osuna11/edin_codigo_usher/Guantes finales render/Nuevos archivos/files para proto/Tapacompleta.stl

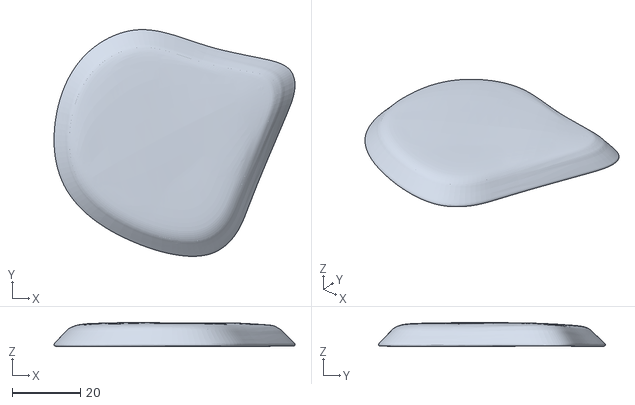
[picture p1: CAD file, 2021-05-18]
Guantes finales render/Nuevos archivos/files para proto/Tapacompleta.stl
70.7 x 66.5 x 7.12
