osuna11/edin_codigo_usher/Guantes finales render/Nuevos archivos/Solido4.STL

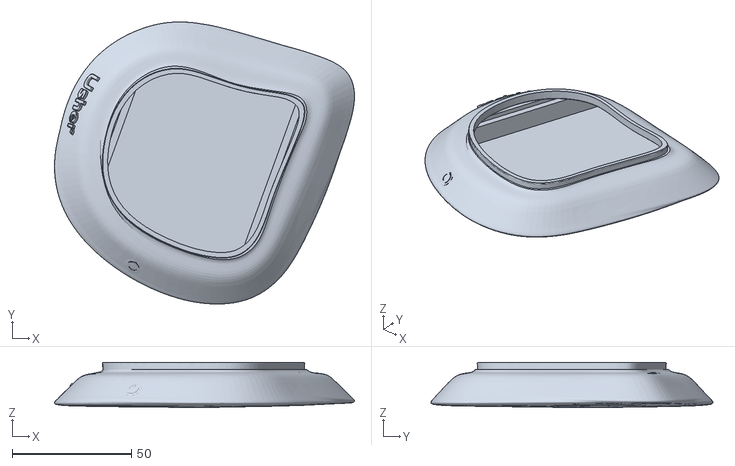
[picture p2: CAD file, 2021-05-18]
Guantes finales render/Nuevos archivos/Solido4.STL
125.7 x 118.2 x 18.9
