osuna11/edin_codigo_usher/Guantes finales render/Nuevos archivos/files para proto/BASE1-CASE.stl

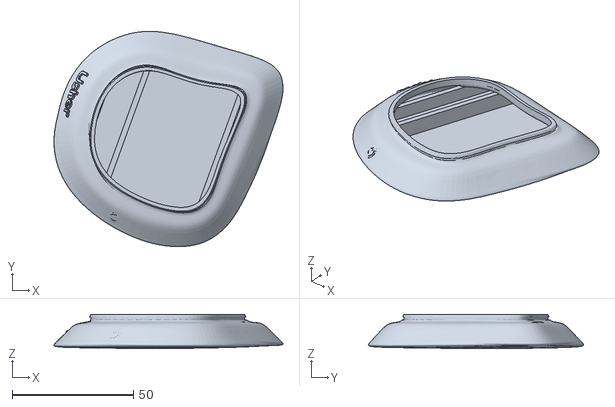
[picture p3: CAD file, 2021-05-18]
Guantes finales render/Nuevos archivos/files para proto/BASE1-CASE.stl
94.3 x 88.7 x 14.1
