osuna11/edin_codigo_usher/Guantes finales render/Nuevos archivos/Solido3.STL

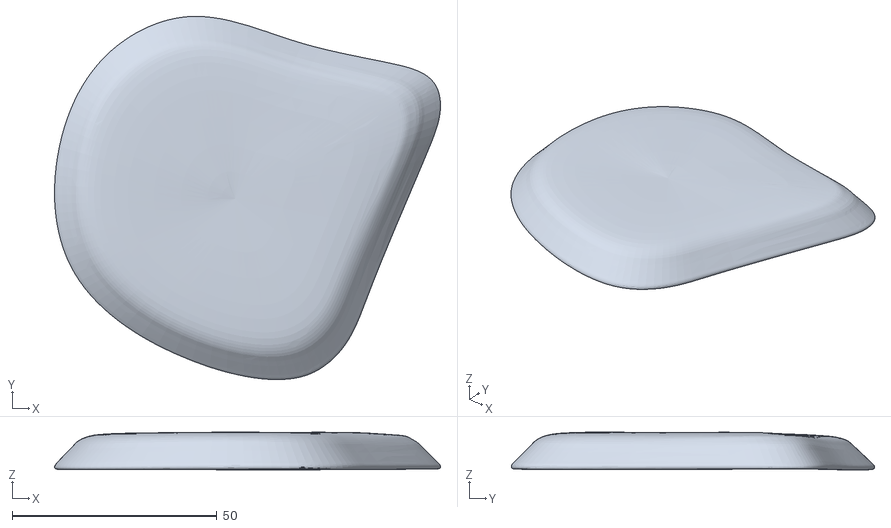
[picture p4: CAD file, 2021-05-18]
Guantes finales render/Nuevos archivos/Solido3.STL
94.3 x 88.7 x 9.22
