osuna11/edin_codigo_usher/Guantes finales render/Nuevos archivos/Solido3 (1).DXF

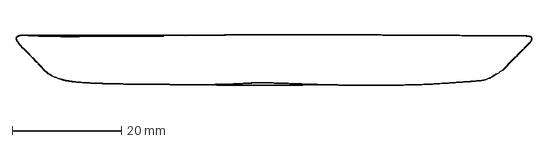
[picture p6: CAD file, 2021-05-18, an earlier design]
Guantes finales render/Nuevos archivos/Solido3 (1).DXF
94.3 x 9.23 mm
