osuna11/edin_codigo_usher/(list of files, cad)

Other CAD files:
Guantes finales render/Nuevos archivos/Solido3.DWG
Guantes finales render/Nuevos archivos/Solido4.DXF
