osuna11/edin_codigo_usher/Placa final/placa_final.brd

## EAGLE design Placa final/placa_final.brd (2021-05-18)

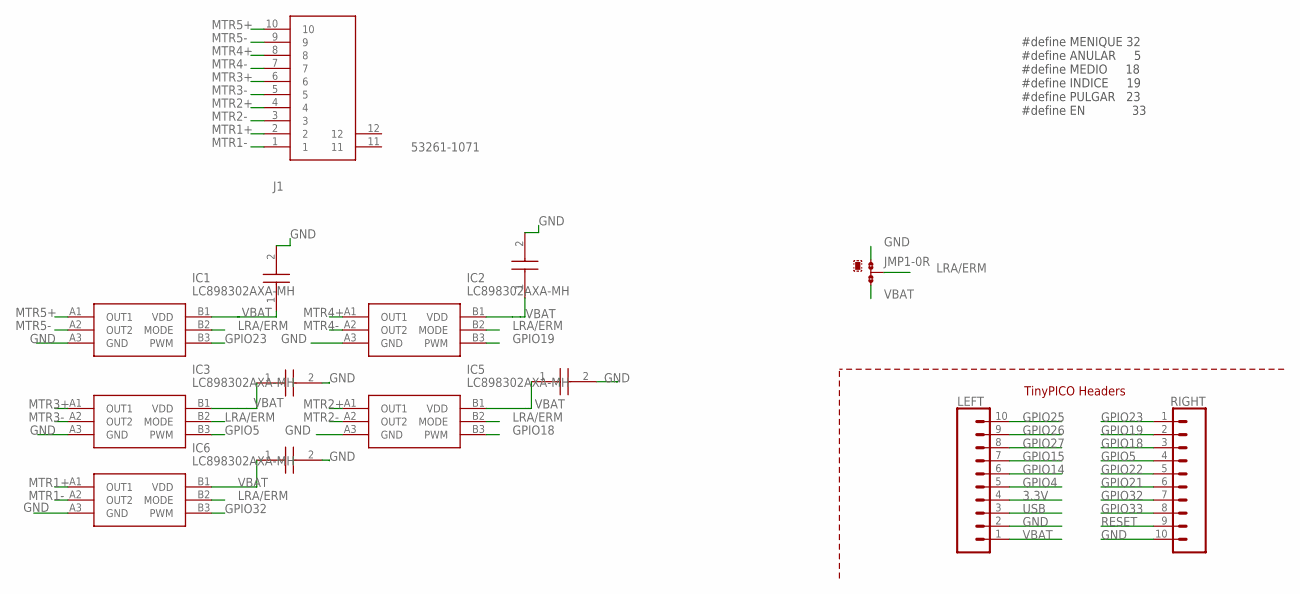
[picture p7: schematic placa_final.sch, sheet 1]

Parts:
C1, C2, C3, C4, C5: 0603B104K160CT; CAPC1608X87N
IC1, IC2, IC3, IC5, IC6: LC898302AXA-MH; BGA6C40P3X2_118X78X65
J1: 53261-1071; 532611071
JMP1: 0R-JUMPA; A0R-JMP
LEFT: TINYPICO_HEADER_10NO_SILK_PTH_FEMALE; 1X10_NO_SILK
RIGHT: TINYPICO_HEADER_10NO_SILK_PTH_FEMALE; 1X10_NO_SILK

Connections:
3.3V: LEFT.4; also elsewhere on the board
GND: C1.2, C2.2, C3.2, C4.2, C5.2, IC1.A3 (GND), IC2.A3 (GND), IC3.A3 (GND), IC5.A3 (GND), IC6.A3 (GND), JMP1.1, LEFT.2, RIGHT.10; also elsewhere on the board
GPIO4: LEFT.5; also elsewhere on the board
GPIO5: IC3.B3 (PWM), RIGHT.4
GPIO14: LEFT.6; also elsewhere on the board
GPIO15: LEFT.7; also elsewhere on the board
GPIO18: IC5.B3 (PWM), RIGHT.3
GPIO19: IC2.B3 (PWM), RIGHT.2
GPIO21: RIGHT.6
GPIO22: RIGHT.5
GPIO23: IC1.B3 (PWM), RIGHT.1
GPIO25: LEFT.10
GPIO26: LEFT.9
GPIO27: LEFT.8; also elsewhere on the board
GPIO32: IC6.B3 (PWM), RIGHT.7
GPIO33: RIGHT.8
LRA/ERM: IC1.B2 (MODE), IC2.B2 (MODE), IC3.B2 (MODE), IC5.B2 (MODE), IC6.B2 (MODE), JMP1.2
MTR1+: IC6.A1 (OUT1), J1.2
MTR1-: IC6.A2 (OUT2), J1.1
MTR2+: IC5.A1 (OUT1), J1.4
MTR2-: IC5.A2 (OUT2), J1.3
MTR3+: IC3.A1 (OUT1), J1.6
MTR3-: IC3.A2 (OUT2), J1.5
MTR4+: IC2.A1 (OUT1), J1.8
MTR4-: IC2.A2 (OUT2), J1.7
MTR5+: IC1.A1 (OUT1), J1.10
MTR5-: IC1.A2 (OUT2), J1.9
RESET: RIGHT.9; also elsewhere on the board
USB: LEFT.3
VBAT: C1.1, C2.1, C3.1, C4.1, C5.1, IC1.B1 (VDD), IC2.B1 (VDD), IC3.B1 (VDD), IC5.B1 (VDD), IC6.B1 (VDD), JMP1.3, LEFT.1

Notes on the sheet:
TinyPICO Headers
#define MENIQUE 32 #define ANULAR 5 #define MEDIO 18 #define INDICE 19 #define PULGAR 23 #define EN 33

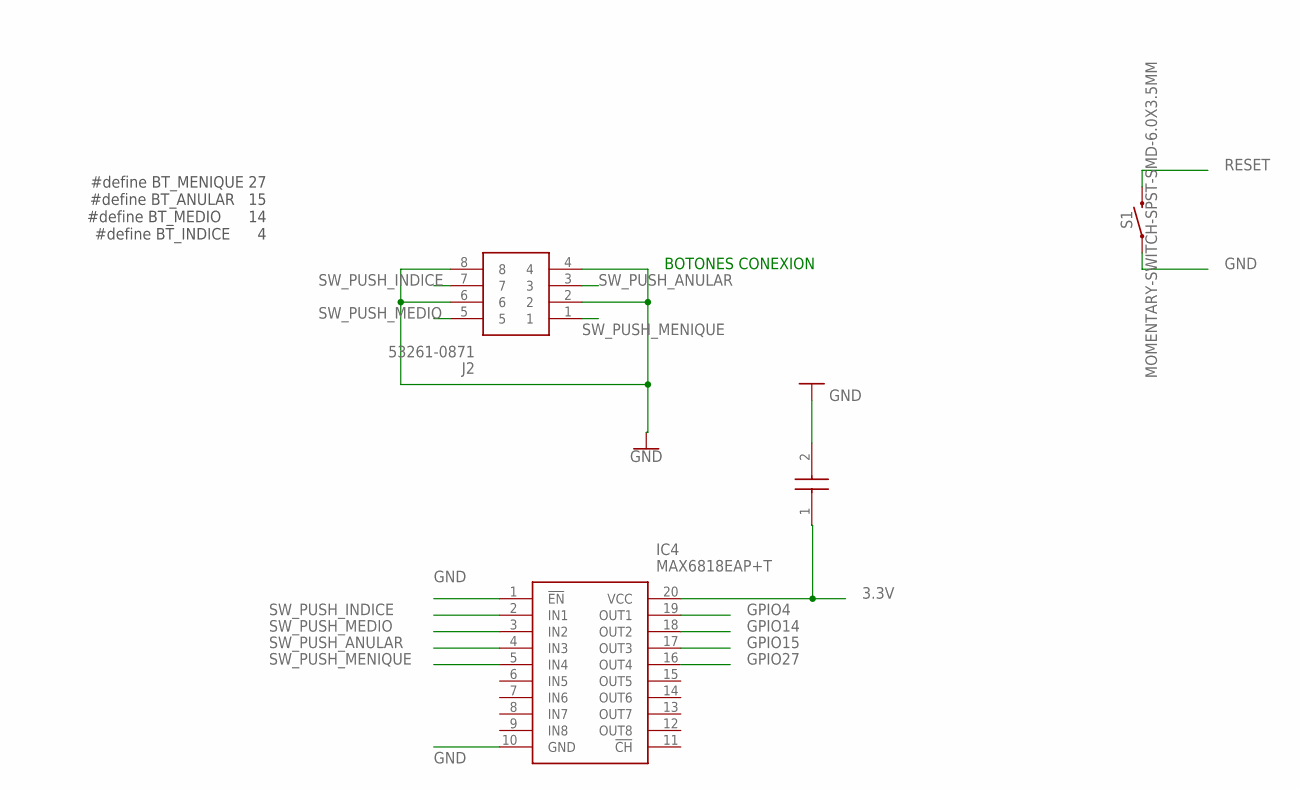
[picture p8: schematic placa_final.sch, sheet 2, Botons]

Parts:
C8: 0603B104K160CT; CAPC1608X87N
IC4: MAX6818EAP+T; SOP65P778X199-20N
J2: 53261-0871
S1: MOMENTARY-SWITCH-SPST-SMD-6.0X3.5MM; TACTILE_SWITCH_SMD_6.0X3.5MM

Connections:
3.3V: C8.1, IC4.20 (VCC); also elsewhere on the board
GND: C8.2, IC4.1 (!EN), IC4.10 (GND), J2.2, J2.4, J2.6, J2.8, S1.1; also elsewhere on the board
GPIO4: IC4.19 (OUT1); also elsewhere on the board
GPIO14: IC4.18 (OUT2); also elsewhere on the board
GPIO15: IC4.17 (OUT3); also elsewhere on the board
GPIO27: IC4.16 (OUT4); also elsewhere on the board
RESET: S1.2; also elsewhere on the board
SW_PUSH_ANULAR: IC4.4 (IN3), J2.3
SW_PUSH_INDICE: IC4.2 (IN1), J2.7
SW_PUSH_MEDIO: IC4.3 (IN2), J2.5
SW_PUSH_MENIQUE: IC4.5 (IN4), J2.1

Notes on the sheet:
#define BT_MENIQUE 27 #define BT_ANULAR 15 #define BT_MEDIO 14 #define BT_INDICE 4
BOTONES CONEXION

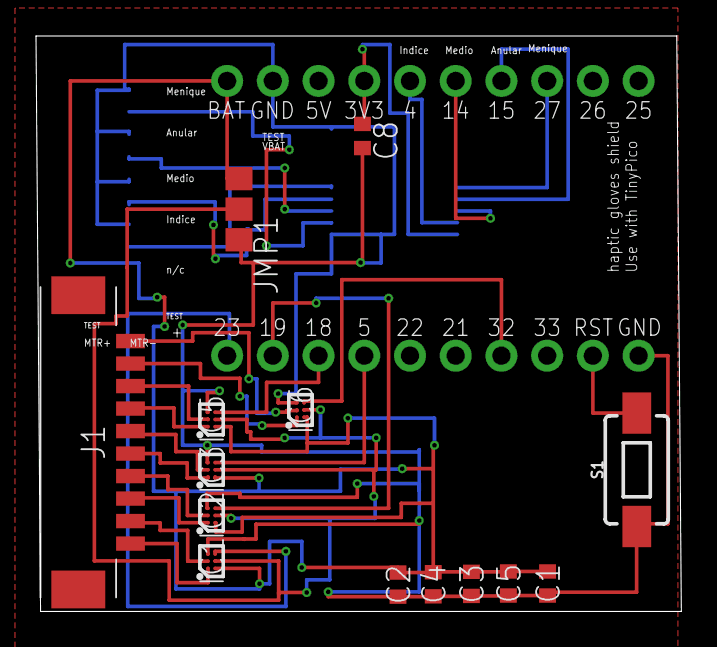
[picture p9: board placa_final.brd from above]

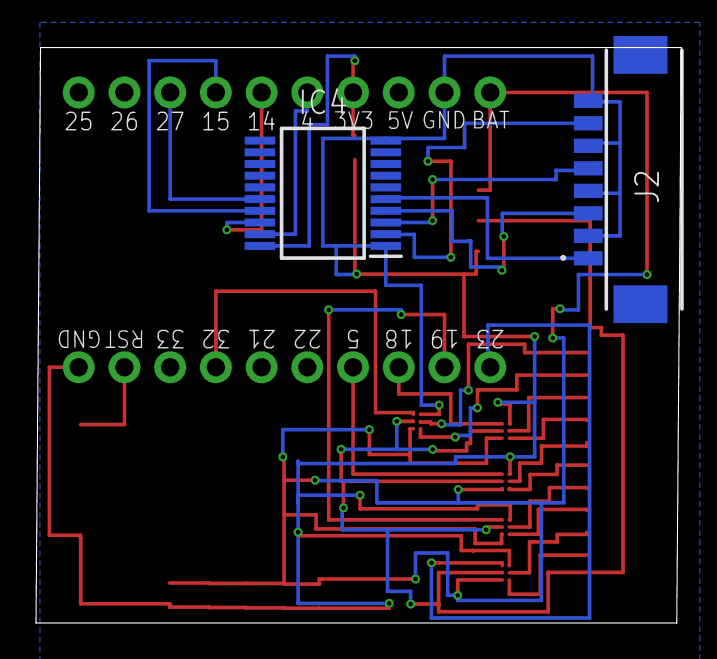
[picture p10: board placa_final.brd from below]

Board: 2 copper layers, 35.9 x 32.0 mm, 18 parts (2 on the bottom side), 28 nets.
