osuna11/edin_codigo_usher/placa 3 cm.brd

## EAGLE design placa 3 cm.brd (2021-03-17)

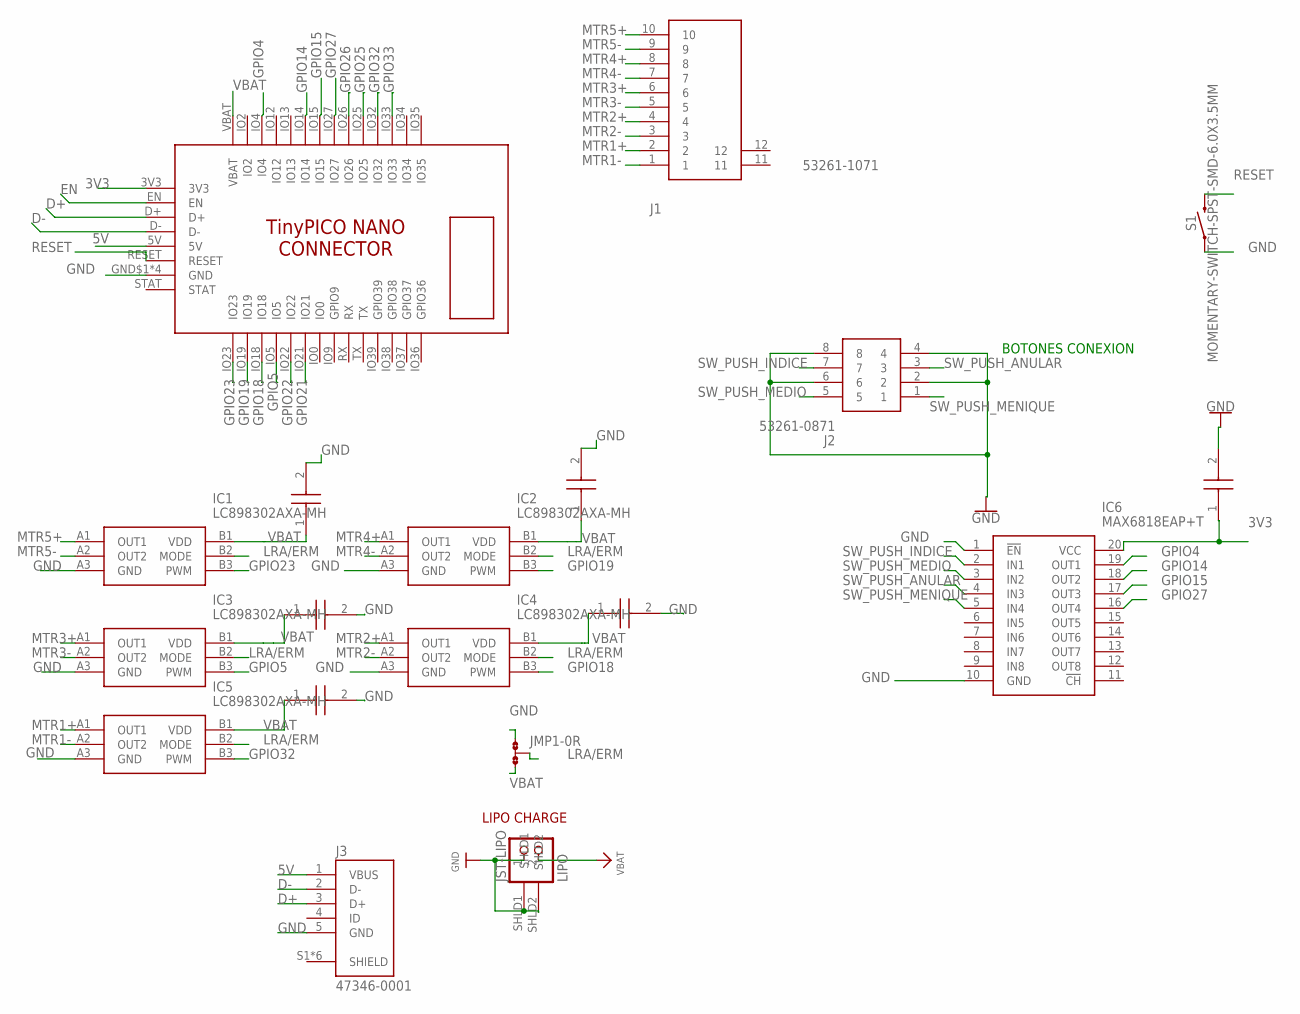
[picture p11: schematic placa 3 cm.sch, sheet 1]

Parts:
C1, C2, C3, C4, C5, C8: 0603B104K160CT; CAPC1608X87N
IC1, IC2, IC3, IC4, IC5: LC898302AXA-MH; BGA6C40P3X2_118X78X65
IC6: MAX6818EAP+T; SOP65P778X199-20N
J1: 53261-1071; 532611071
J2: 53261-0871
J3: 47346-0001; MOLEX_47346-0001
JMP1: 0R-JUMPA; A0R-JMP
JST-LIPO: LIPO; JSTPH2
S1: MOMENTARY-SWITCH-SPST-SMD-6.0X3.5MM; TACTILE_SWITCH_SMD_6.0X3.5MM
U$1: TINYPICO-NANO-CONNECTOR

Connections:
3V3: C8.1, IC6.20 (VCC), U$1.3V3
5V: J3.1 (VBUS), U$1.5V
D+: J3.3 (D+), U$1.D+
D-: J3.2 (D-), U$1.D-
EN: U$1.EN
GND: C1.2, C2.2, C3.2, C4.2, C5.2, C8.2, IC1.A3 (GND), IC2.A3 (GND), IC3.A3 (GND), IC4.A3 (GND), IC5.A3 (GND), IC6.1 (!EN), IC6.10 (GND), J2.2, J2.4, J2.6, J2.8, J3.5 (GND), JMP1.1, JST-LIPO.1, JST-LIPO.SHLD1, JST-LIPO.SHLD2, S1.1, U$1.GND$1 (GND), U$1.GND$2 (GND), U$1.GND$3 (GND), U$1.GND$4 (GND)
GPIO4: IC6.19 (OUT1), U$1.IO4
GPIO5: IC3.B3 (PWM), U$1.IO5
GPIO14: IC6.18 (OUT2), U$1.IO14
GPIO15: IC6.17 (OUT3), U$1.IO15
GPIO18: IC4.B3 (PWM), U$1.IO18
GPIO19: IC2.B3 (PWM), U$1.IO19
GPIO21: U$1.IO21
GPIO22: U$1.IO22
GPIO23: IC1.B3 (PWM), U$1.IO23
GPIO25: U$1.IO25
GPIO26: U$1.IO26
GPIO27: IC6.16 (OUT4), U$1.IO27
GPIO32: IC5.B3 (PWM), U$1.IO32
GPIO33: U$1.IO33
LRA/ERM: IC1.B2 (MODE), IC2.B2 (MODE), IC3.B2 (MODE), IC4.B2 (MODE), IC5.B2 (MODE), JMP1.2
MTR1+: IC5.A1 (OUT1), J1.2
MTR1-: IC5.A2 (OUT2), J1.1
MTR2+: IC4.A1 (OUT1), J1.4
MTR2-: IC4.A2 (OUT2), J1.3
MTR3+: IC3.A1 (OUT1), J1.6
MTR3-: IC3.A2 (OUT2), J1.5
MTR4+: IC2.A1 (OUT1), J1.8
MTR4-: IC2.A2 (OUT2), J1.7
MTR5+: IC1.A1 (OUT1), J1.10
MTR5-: IC1.A2 (OUT2), J1.9
RESET: S1.2, U$1.RESET
SW_PUSH_ANULAR: IC6.4 (IN3), J2.3
SW_PUSH_INDICE: IC6.2 (IN1), J2.7
SW_PUSH_MEDIO: IC6.3 (IN2), J2.5
SW_PUSH_MENIQUE: IC6.5 (IN4), J2.1
VBAT: C1.1, C2.1, C3.1, C4.1, C5.1, IC1.B1 (VDD), IC2.B1 (VDD), IC3.B1 (VDD), IC4.B1 (VDD), IC5.B1 (VDD), JMP1.3, JST-LIPO.2, U$1.VBAT

Notes on the sheet:
BOTONES CONEXION
LIPO CHARGE

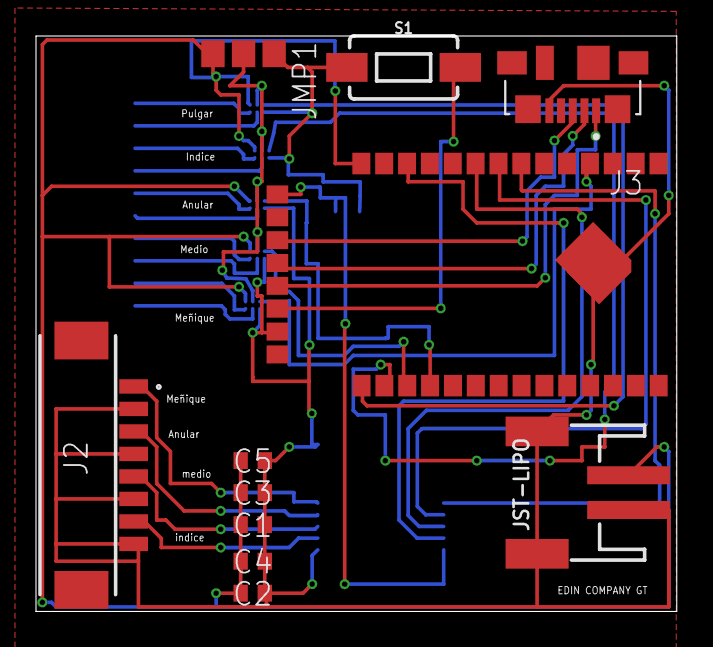
[picture p12: board placa 3 cm.brd from above]

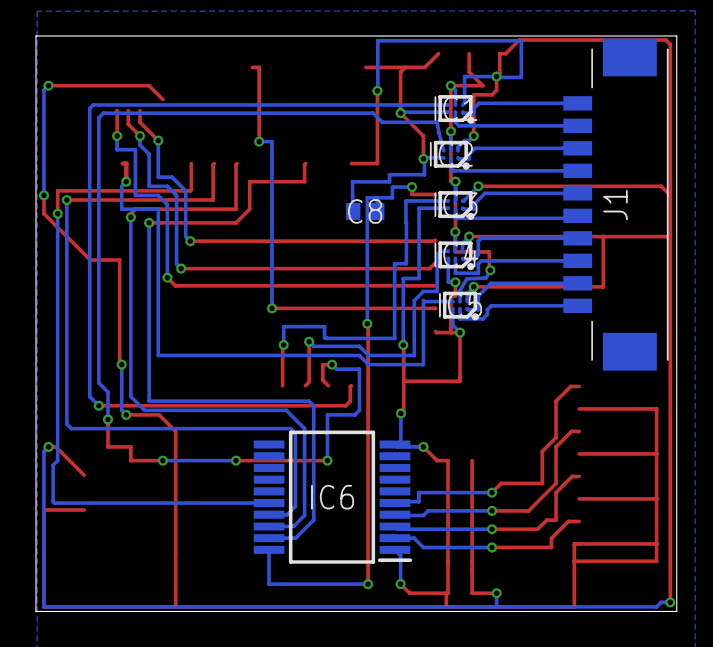
[picture p13: board placa 3 cm.brd from below]

Board: 2 copper layers, 35.6 x 32.0 mm, 19 parts (8 on the bottom side), 31 nets.
